Tero-Labs/elektra-OBD-device_0.1/README.md

Tero Labs

> Designing Electric Vehicles capable of autonomously participating in a decentralized, sharing economy at a much lower cost than now.   

:warning: :warning: :warning:
>Deprecation Warning: 
This repo is no longer maintained. Please have a look at the newer [elektra-OBD-Device_v1.0](https://github.com/Tero-Labs/elektra-OBD-device_v1.0) based on the ESP32.

# Elektra-OBD-Device_v0.1
OBD data monitoring tool based on MCP2551 & MCP2515 for project elektra. The device is designed as a Raspberry Pi hat compatible with Raspberry Pi Zero W.

## Board 
Top             |  Bottom
:-------------------------:|:-------------------------:
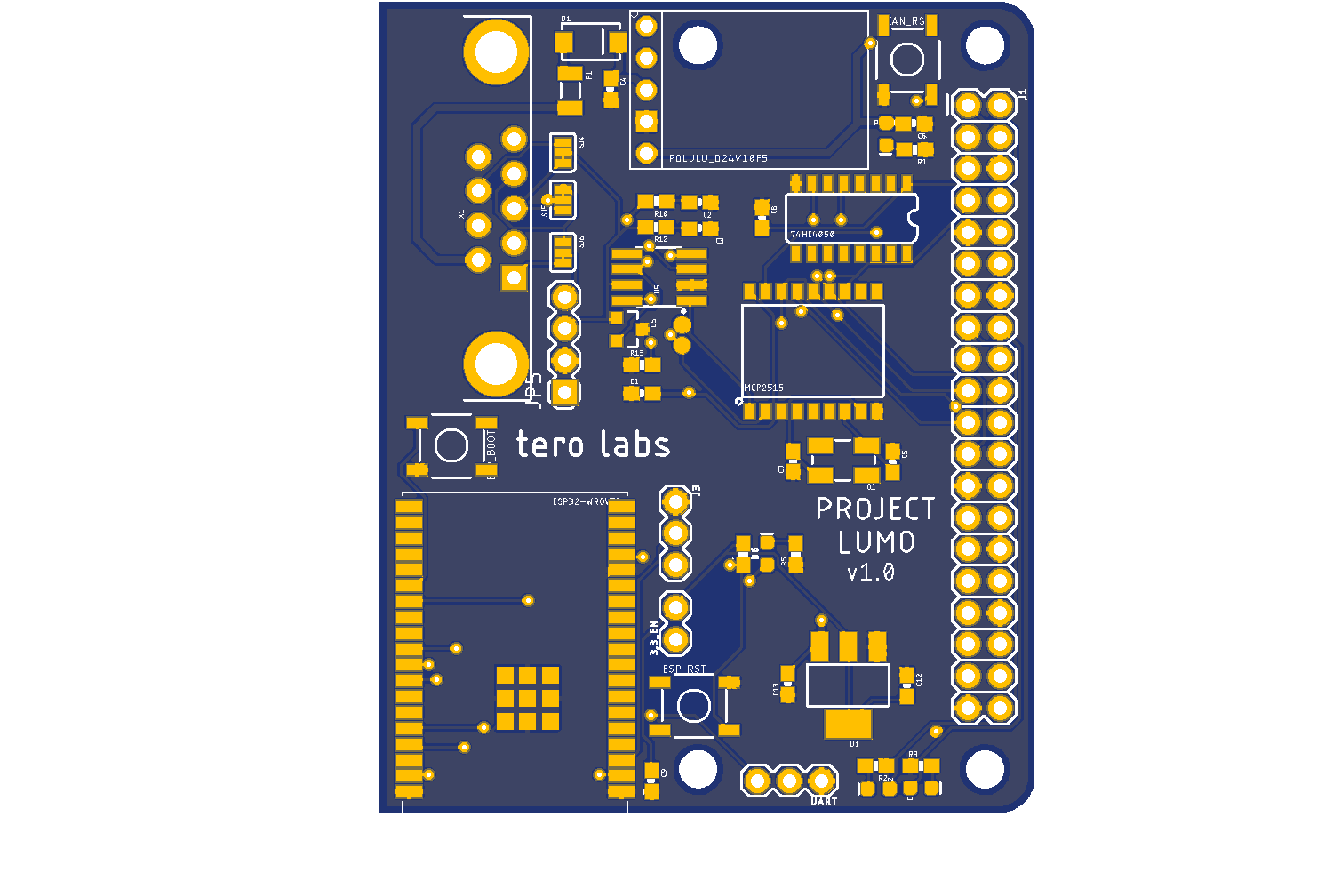
[picture p1: photos/can bus hat_top.png]
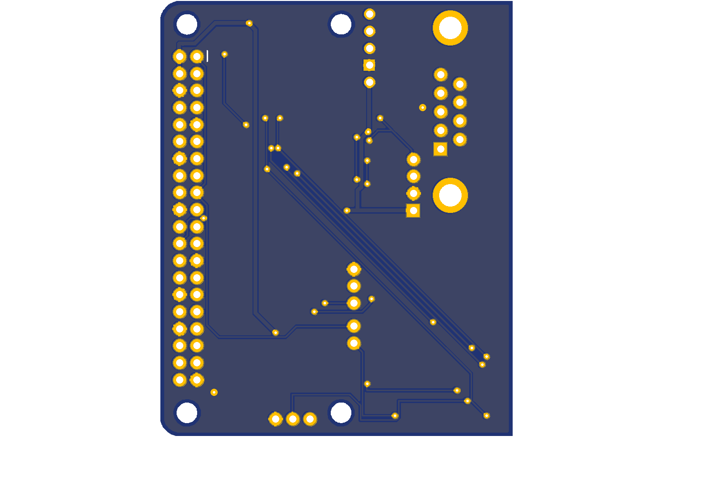
[picture p2: photos/can bus hat_bottom.png]
  |  

Eagle project files  are given. The Cam output files are also present for ordering through PCB fabrication services.

## Assembly & Enclosure

Board             |  Enclosure
:-------------------------:|:-------------------------:
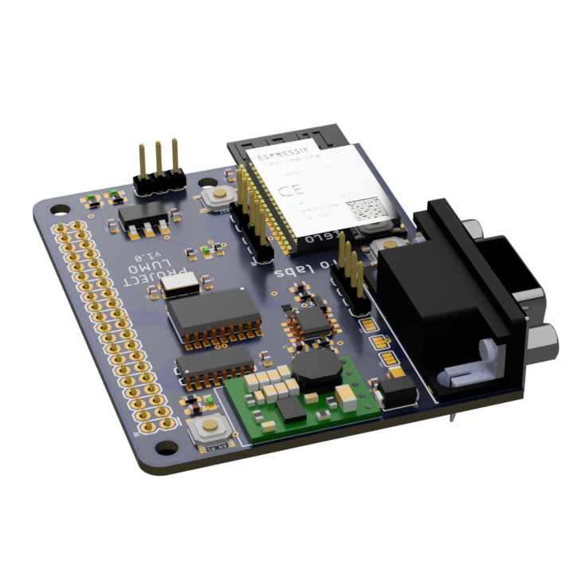
[picture p3: photos/render_RTX.png]
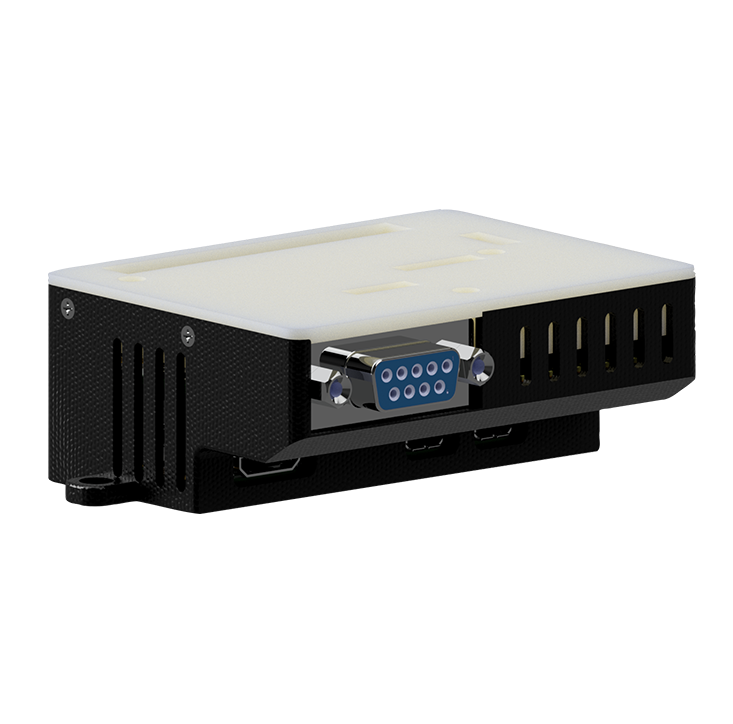
[picture p4: photos/enclosure-rtx.png]
  |  

## Enclosure Printing Instructions
+ 0.3 layer height
+ PLA/ABS (ABS preferred)
+ 4x m1.5 countersink screws required

# License
<br />This work is licensed under a <a rel="license" href="http://creativecommons.org/licenses/by-nc-sa/4.0/">Creative Commons Attribution-NonCommercial-ShareAlike 4.0 International License</a>.
