Tero-Labs/elektra-OBD-device_0.1/photos/render_top.png

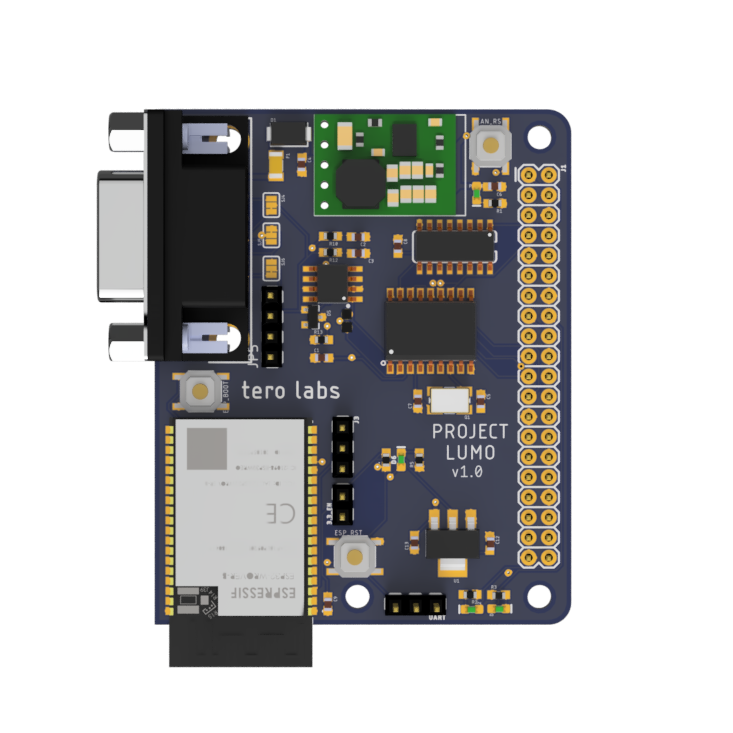
photos/render_top.png
