Tero-Labs/elektra-OBD-device_0.1/photos/schematic.png

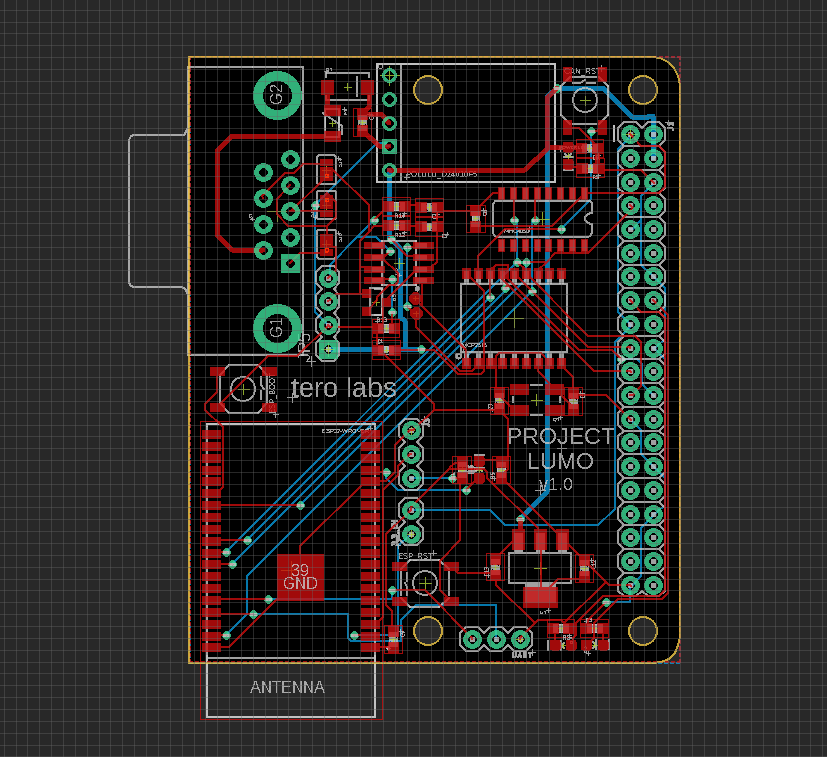
photos/schematic.png
