Tero-Labs/elektra-OBD-device_0.1/enclosure/case_bottom.stl

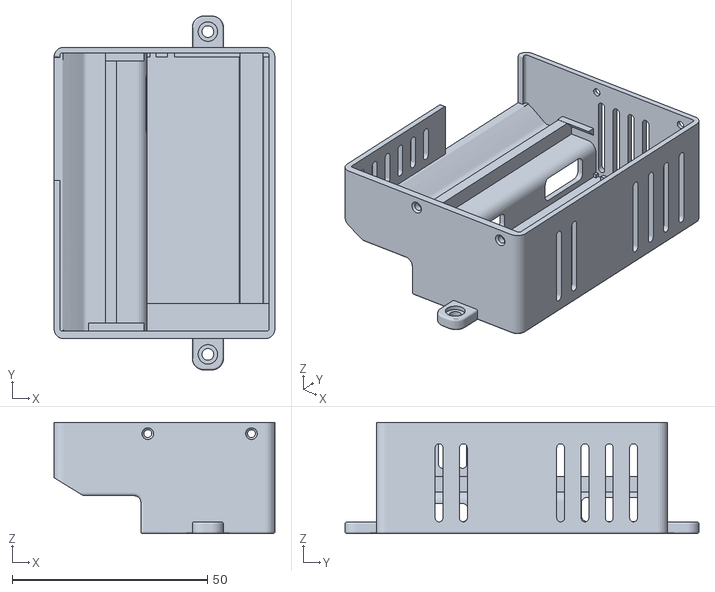
[picture p7: CAD file, 2021-07-13]
enclosure/case_bottom.stl
56.5 x 90.6 x 28.5
