Tero-Labs/elektra-OBD-device_0.1/enclosure/case_top.stl

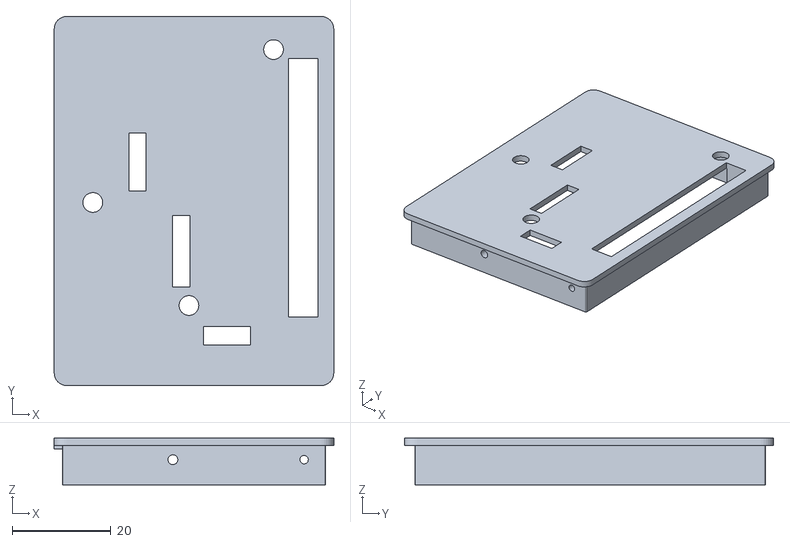
[picture p8: CAD file, 2021-07-13]
enclosure/case_top.stl
56.5 x 74.6 x 9.50
