Tero-Labs/elektra-OBD-device_0.1/can bus hat.brd

## EAGLE design can bus hat.brd (2021-07-13)

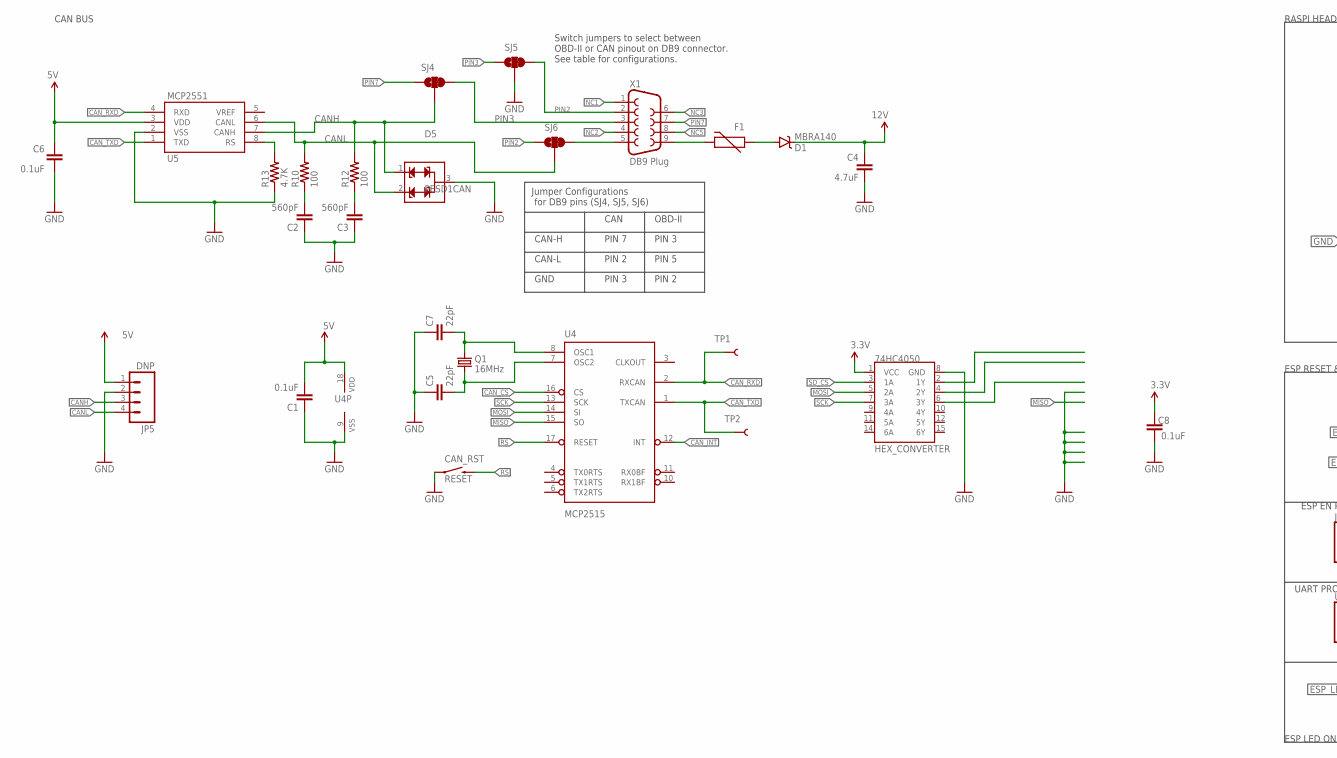
[picture p9: schematic can bus hat.sch, part in row 1, column 1]

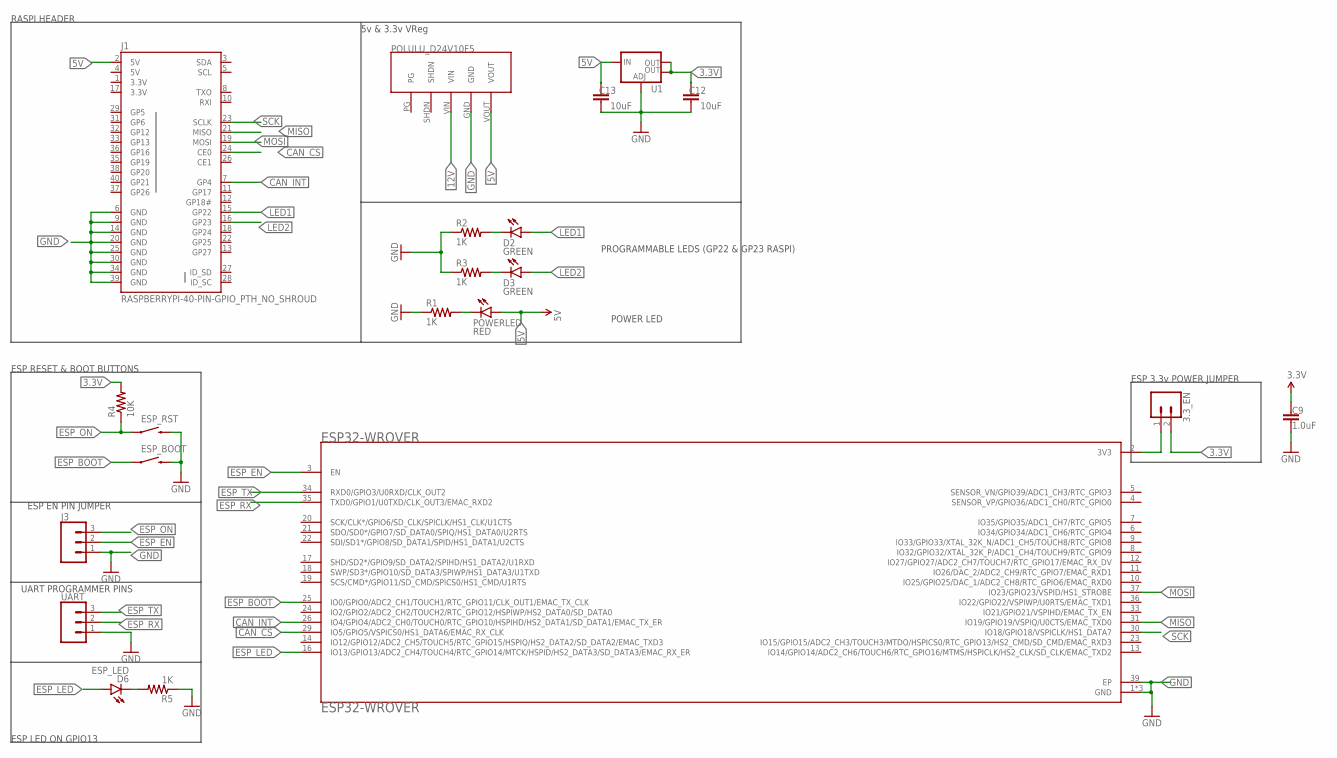
[picture p10: schematic can bus hat.sch, part in row 1, column 2]

Parts:
3.3_EN: CONN_02; 1X02
74HC4050: HEX_CONVERTER; SO016
C1, C6, C8: 0.1uF; 0603-CAP
C2, C3: 560pF; 0603-CAP
C4: 4.7uF; 0603-CAP
C5, C7: 22pF; 0603-CAP
C9: 1.0uF; 0603-CAP
C12, C13: 10uF; 0603-CAP
CAN_RST: RESET; TACTILE-SWITCH-SMD
D1: MBRA140; SMA-DIODE
D2, D3: GREEN; LED-0603
D5: PESD1CAN; SOT23-3
D6: ESP_LED; LED-0603
ESP32-WROVER: ESP32-WROVER; XCVR_ESP32-WROVER
ESP_BOOT: RESET; TACTILE-SWITCH-SMD
ESP_RST: RESET; TACTILE-SWITCH-SMD
F1: PTCTHERMISTOR1206; PTC-1206
J1: RASPBERRYPI-40-PIN-GPIO_PTH_NO_SHROUD; 2X20
J3: CONN_03; 1X03
JP5: DNP; 1X04
POLULU_D24V10F5: POLOLU5V,1ASTEP-DOWNVOLTAGEREGULATORD24V10F5; POLULU-VREG
POWERLED: RED; LED-0603
Q1: 16MHz; CRYSTAL-SMD-5X3
R1, R2, R3, R5: 1K; 0603-RES
R4: 10K; 0603-RES
R10, R12: 100; 0603-RES
R13: 4.7K; 0603-RES
SJ4, SJ5, SJ6: JUMPER-PAD-3-2OF3_NC_BY_TRACE_SMALL; PAD-JUMPER-3-2OF3_NC_BY_TRACE_YES_SILK_FULL_BOX
TP1, TP2: TEST-POINT3X5; PAD.03X.05
U1: VR_REGULATOR_LM1117SOT223; SOT223
U4: MCP2515; SO-18W
U5: MCP2551; SO08
UART: CONN_03; 1X03
X1: DB9 Plug; DB9_MALE

Connections:
3.3V: 3.3_EN.2, 74HC4050.1 (VCC), C8.2, C9.1, C12.2, J1.1 (3.3V), J1.17 (3.3V), R4.2, U1.2 (OUT), U1.4 (OUT)
5V: C1.2, C6.2, C13.2, J1.2 (5V), J1.4 (5V), JP5.1, POLULU_D24V10F5.VOUT, POWERLED.A, U1.3 (IN), U4.18 (VDD), U5.3 (VDD)
12V: C4.1, D1.C, POLULU_D24V10F5.VIN
CANH: D5.1, JP5.3, R12.2, SJ4.2, U5.7 (CANH)
CANL: D5.2, JP5.4, R10.2, SJ6.2, U5.6 (CANL)
CAN_CS: ESP32-WROVER.29 (IO5/GPIO5/VSPICS0/HS1_DATA6/EMAC_RX_CLK), J1.24 (CE0), U4.16 (CS)
CAN_INT: ESP32-WROVER.26 (IO4/GPIO4/ADC2_CH0/TOUCH0/RTC_GPIO10/HS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), J1.7 (GP4), U4.12 (INT)
CAN_RXD: TP1.P$1, U4.2 (RXCAN), U5.4 (RXD)
CAN_TXD: TP2.P$1, U4.1 (TXCAN), U5.1 (TXD)
ESP_BOOT: ESP32-WROVER.25 (IO0/GPIO0/ADC2_CH1/TOUCH1/RTC_GPIO11/CL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), ESP_BOOT.1
ESP_EN: ESP32-WROVER.3 (EN), J3.2
ESP_LED: D6.A, ESP32-WROVER.16 (IO13/GPIO13/ADC2_CH4/TOUCH4/RTC_GPIO14/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)
ESP_ON: ESP_RST.1, J3.3, R4.1
ESP_RX: ESP32-WROVER.35 (TXD0/GPIO1/U0TXD/CLK_OUT3/EMAC_RXD2), UART.2
ESP_TX: ESP32-WROVER.34 (RXD0/GPIO3/U0RXD/CLK_OUT2), UART.3
GND: 74HC4050.8 (GND), C1.1, C2.1, C3.1, C4.2, C5.1, C6.1, C7.1, C8.1, C9.2, C12.1, C13.1, CAN_RST.1, D5.3, ESP32-WROVER.1 (GND), ESP32-WROVER.15 (GND), ESP32-WROVER.38 (GND), ESP32-WROVER.39 (EP), ESP_BOOT.3 (2), ESP_RST.3 (2), J1.6 (GND), J1.9 (GND), J1.14 (GND), J1.20 (GND), J1.25 (GND), J1.30 (GND), J1.34 (GND), J1.39 (GND), J3.1, JP5.2, POLULU_D24V10F5.GND, R1.1, R2.1, R3.1, R5.1, R13.1, SJ5.2, U1.1 (ADJ), U4.9 (VSS), U5.2 (VSS), UART.1
LED1: D2.A, J1.15 (GP22)
LED2: D3.A, J1.16 (GP23)
MISO: ESP32-WROVER.31 (IO19/GPIO19/VSPIQ/U0CTS/EMAC_TXD0), J1.21 (MISO), U4.15 (SO)
MOSI: 74HC4050.5 (2A), ESP32-WROVER.37 (IO23/GPIO23/VSPID/HS1_STROBE), J1.19 (MOSI), U4.14 (SI)
unnamed: SJ6.3, X1.5
unnamed: POWERLED.C, R1.2
unnamed: D2.C, R2.2
unnamed: D3.C, R3.2
unnamed: 3.3_EN.1, ESP32-WROVER.2 (3V3)
unnamed: C2.2, R10.1
unnamed: C3.2, R12.1
unnamed: D6.C, R5.2
unnamed: F1.2, X1.9
unnamed: R13.2, U5.8 (RS)
unnamed: D1.A, F1.1
unnamed: C7.2, Q1.3 (2), U4.8 (OSC1)
unnamed: C5.2, Q1.1, U4.7 (OSC2)
NC1: X1.1
NC2: X1.4
NC3: X1.6
NC5: X1.8
PIN2: SJ5.3, SJ6.1, X1.2
PIN3: SJ4.3, SJ5.1, X1.3
PIN7: SJ4.1, X1.7
RS: CAN_RST.3 (2), U4.17 (RESET)
SCK: 74HC4050.7 (3A), ESP32-WROVER.30 (IO18/GPIO18/VSPICLK/HS1_DATA7), J1.23 (SCLK), U4.13 (SCK)
SD_CS: 74HC4050.3 (1A)

Notes on the sheet:
CAN
OBD-II
CAN-H
CAN-L
GND
PIN 5
PIN 2
PIN 3
PIN 7
Jumper Configurations for DB9 pins (SJ4, SJ5, SJ6)
Switch jumpers to select between OBD-II or CAN pinout on DB9 connector. See table for configurations.
CAN BUS
5v & 3.3v VReg
RASPI HEADER
ESP RESET & BOOT BUTTONS
ESP EN PIN JUMPER
UART PROGRAMMER PINS
ESP LED ON GPIO13
ESP 3.3v POWER JUMPER
PROGRAMMABLE LEDS (GP22 & GP23 RASPI)
POWER LED

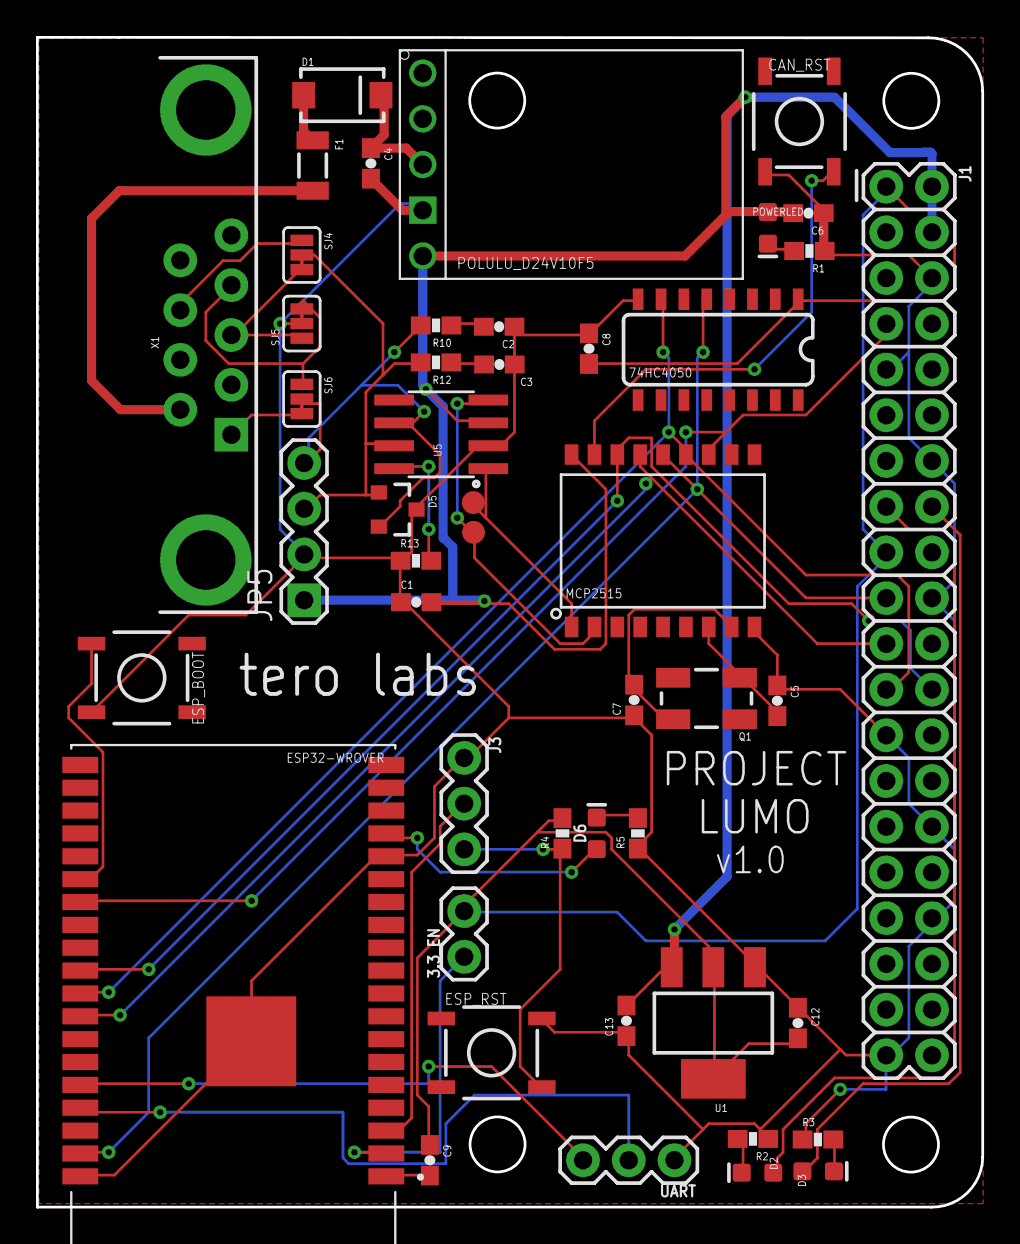
[picture p11: board can bus hat.brd from above]

Board: 2 copper layers, 52.5 x 65.0 mm, 47 parts (0 on the bottom side), 38 nets.
