Tero-Labs/elektra-OBD-device_0.1/(commit log)

2021-06-18 added vi-firmware
    [BLUEBOARD.cfg, FORDBOARD.cfg, canemulator.cfg, flash.cfg, gdb.cfg, olimex-arm-usb-ocd-custom.cfg, olimex-arm-usb-ocd-h-custom.cfg, vi-firmware.cfg]
2021-07-13 Added lumo-can-bus-hat
    [BOM_lumo.csv, can bus hat.brd, can bus hat.sch, case_bottom.stl, case_top.stl]
2021-07-13 vi-toolset added
    [BLUEBOARD.cfg, FORDBOARD.cfg, canemulator.cfg, flash.cfg, gdb.cfg, olimex-arm-usb-ocd-custom.cfg, olimex-arm-usb-ocd-h-custom.cfg, vi-firmware.cfg]
2021-12-08 cleaning repo
    [BLUEBOARD.cfg, BOM_lumo.csv, FORDBOARD.cfg, can bus hat.brd, can bus hat.sch, canemulator.cfg, case_bottom.stl, case_top.stl]
